xoxoaudiolabs/XO-Hugbox/hardware/mechanical/alu_acrylic/xo_hugbox_alu_shell.step

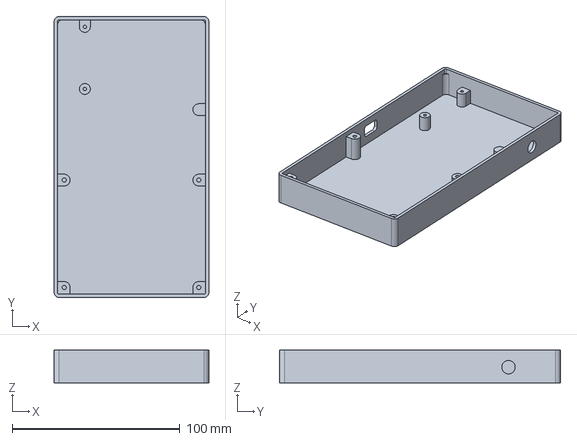
[picture p7: CAD file, 2026-11-07]
hardware/mechanical/alu_acrylic/xo_hugbox_alu_shell.step
92.2 x 167.5 x 19.6 mm
