xoxoaudiolabs/XO-Hugbox/hardware/mechanical/xo_hugbox_top_plate.stl

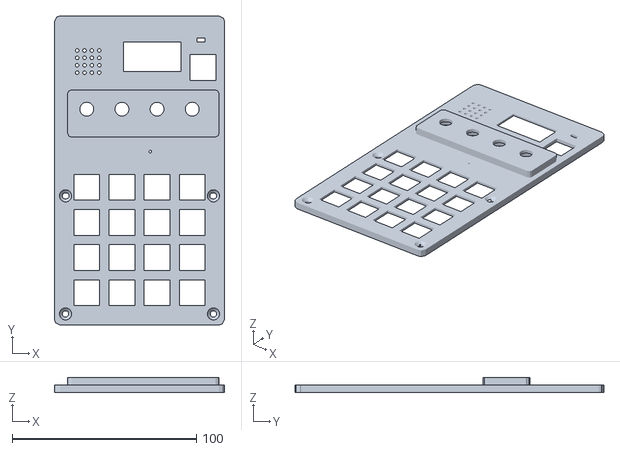
[picture p8: CAD file, 2026-11-06]
hardware/mechanical/xo_hugbox_top_plate.stl
92.2 x 167.5 x 8.12
