xoxoaudiolabs/XO-Hugbox/hardware/mechanical/alu_acrylic/xo_hugbox_acrylic.stl

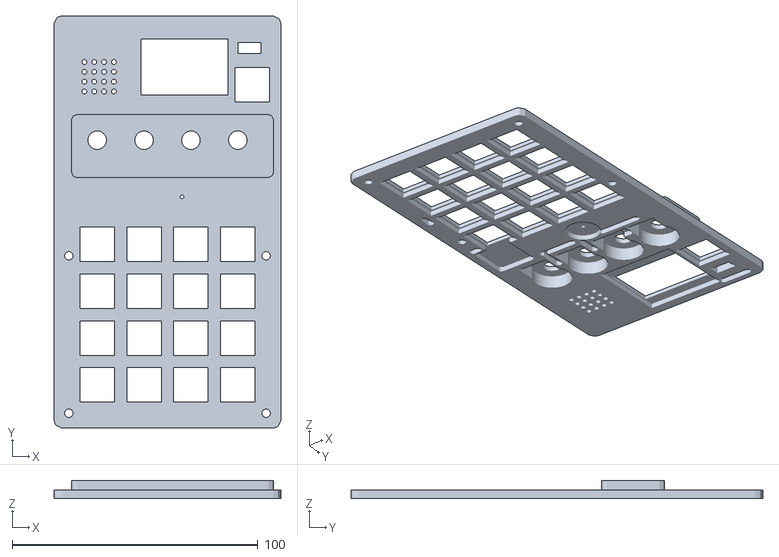
[picture p9: CAD file, 2026-11-07]
hardware/mechanical/alu_acrylic/xo_hugbox_acrylic.stl
92.2 x 167.5 x 7.50
