xoxoaudiolabs/XO-Hugbox/hardware/mechanical/xo_hugbox_shell.stl

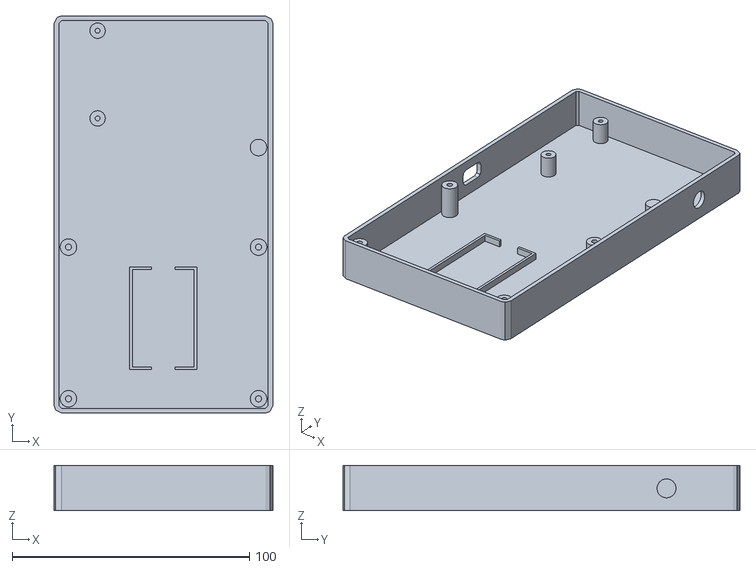
[picture p10: CAD file, 2026-11-05]
hardware/mechanical/xo_hugbox_shell.stl
92.2 x 167.5 x 19.1
