xoxoaudiolabs/XO-Hugbox/hardware/mechanical/alu_acrylic/xo_hugbox_acrylic_L4.dxf

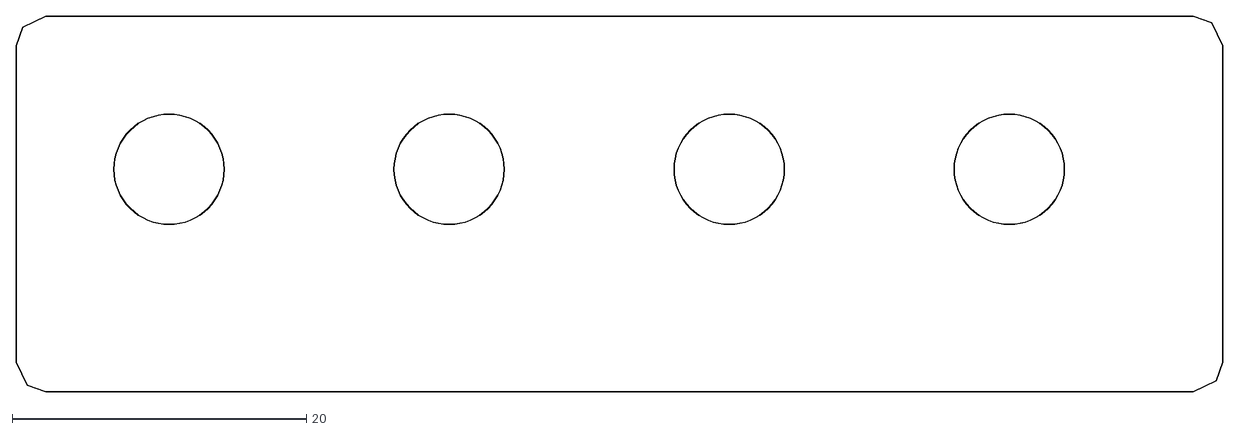
[picture p11: CAD file, 2026-11-07]
hardware/mechanical/alu_acrylic/xo_hugbox_acrylic_L4.dxf
82.1 x 25.5
