xoxoaudiolabs/XO-Hugbox/hardware/mechanical/alu_acrylic/xo_hugbox_acrylic_L2.dxf

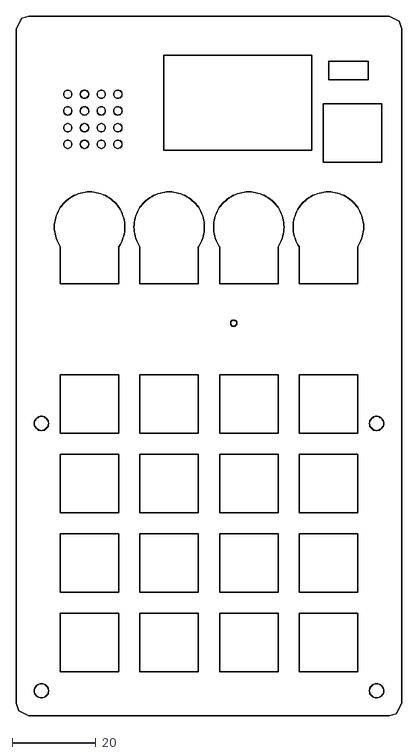
[picture p12: CAD file, 2026-11-07]
hardware/mechanical/alu_acrylic/xo_hugbox_acrylic_L2.dxf
92.2 x 167.5
