xoxoaudiolabs/XO-Hugbox/hardware/mechanical/alu_acrylic/xo_hugbox_acrylic_L3.dxf

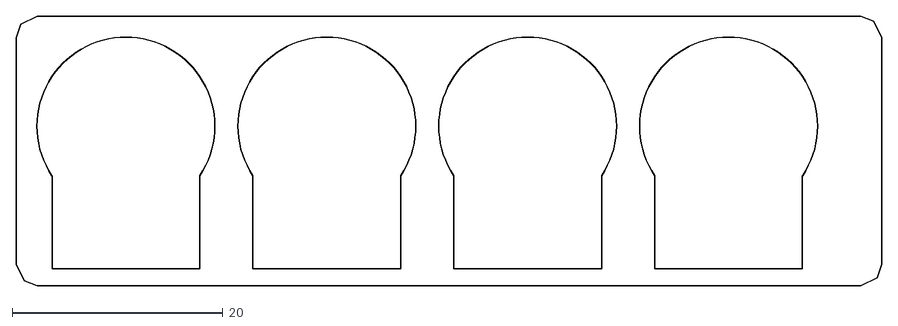
[picture p13: CAD file, 2026-11-07]
hardware/mechanical/alu_acrylic/xo_hugbox_acrylic_L3.dxf
82.1 x 25.5
