xoxoaudiolabs/XO-Hugbox/hardware/mechanical/alu_acrylic/xo_hugbox_acrylic_L1.dxf

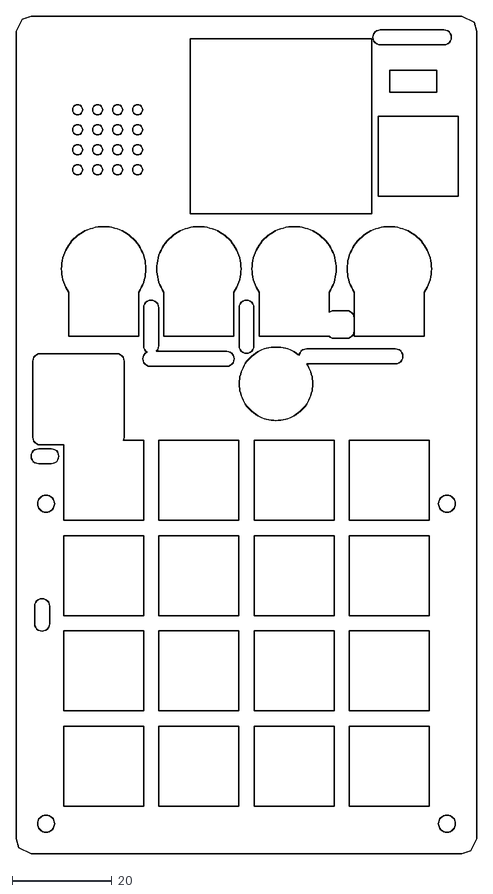
[picture p14: CAD file, 2026-11-07]
hardware/mechanical/alu_acrylic/xo_hugbox_acrylic_L1.dxf
92.2 x 167.5
