xoxoaudiolabs/XO-Hugbox/hardware/mechanical/alu_acrylic/xo_hugbox_acrylic.scad

// XO-Hugbox - clear acrylic faceplate, 4 laser-cut layers (generated by gen_acrylic.py from layout.py; do not edit)
// layer=1..4 -> that layer's 2D outline (export DXF/SVG); layer=0 -> 3D stack in shell coordinates (preview).
// 1: under-layer 2.0 mm   2: switch plate 1.5 mm   3: knob spacer 2.0 mm   4: knob top 2.0 mm
layer=0;
W=92.2; H=167.5; r=3; pitch=19.05;
z1=19.60; z2=21.60; z3=23.10; z4=25.10;   // layer undersides (shell z); can top 25.22
t1=2.0; t2=1.5; t3=2.0; t4=2.0;
pot_y=117.0; can_d=16.87; shaft_d=7.5; lug_reach=12.52; strip_front=15.12; strip_x0=7.125;
oled_c=[53.00,145.70]; oled_pcb=[36.4,35.00]; oled_pcb_cy=145.50;
oled_glass=[35.50,22.73]; oled_glass_off=1.08;
spk_c=[18.30,142.80]; grille_r=10;
shift=[80.5,139.5]; pwr=[79.5,154.5]; pwr_window=true;
mic_c=[52.0,94.0]; mic_d=13.9; mic_hole=1.5;
top_holes=[[6, 6], [86.2, 6], [6, 70], [86.2, 70]];   // corners only: the knob strip has no screw (support post under it)
reliefs=[[[11.5, 80.5]], [[72.9, 163.3], [75.44, 163.3], [77.98, 163.3], [80.52, 163.3], [83.06, 163.3], [85.6, 163.3]], [[4.88, 98.52], [7.42, 98.52], [9.96, 98.52], [12.5, 98.52], [15.04, 98.52], [17.58, 98.52], [20.12, 98.52], [4.88, 83.28], [7.42, 83.28], [9.96, 83.28], [12.5, 83.28], [15.04, 83.28], [17.58, 83.28], [20.12, 83.28]], [[4.5, 79.5], [7.04, 79.5]], [[63.6, 104.6], [66.14, 104.6], [63.6, 107.14], [66.14, 107.14]], [[5.2, 46.0], [5.2, 49.5]], [[58.11, 99.5], [60.65, 99.5], [63.19, 99.5], [65.73, 99.5], [68.27, 99.5], [70.81, 99.5], [73.35, 99.5], [75.89, 99.5]], [[26.88, 99.0], [29.42, 99.0], [31.96, 99.0], [34.5, 99.0], [37.04, 99.0], [39.58, 99.0], [42.12, 99.0]], [[46.1, 101.6], [46.1, 109.22]], [[27.0, 101.6], [27.0, 109.22]]];
function cx(i)=8.0+pitch/2+i*pitch; function cy(j)=8.0+pitch/2+j*pitch;
keys=[for(i=[0:3]) for(j=[0:3]) [cx(i),cy(j)], shift];
module sq(c,s) translate([c[0]-s[0]/2,c[1]-s[1]/2]) square(s);
module outline() offset(r=r) offset(delta=-r) square([W,H]);
module strip() translate([strip_x0,pot_y-strip_front]) offset(r=2) offset(delta=-2) square([W-3-strip_x0,strip_front+10.4]);
module screws(pts) for(p=pts) translate(p) circle(d=3.4,$fn=32);
module cans() for(i=[0:3]) translate([cx(i),pot_y]) circle(d=can_d,$fn=96);
module lugs() for(i=[0:3]) translate([cx(i)-7,pot_y-(lug_reach+1.0)]) square([14,lug_reach+1.0]);
module grille() for(dx=[-grille_r:4:grille_r]) for(dy=[-grille_r:4:grille_r]) if(dx*dx+dy*dy<=grille_r*grille_r)
  translate([spk_c[0]+dx,spk_c[1]+dy]) circle(d=2,$fn=24);
module pwr_cut() if(pwr_window) sq(pwr,[9.4,4.4]); else sq(pwr,[4.3,2.1]);

// 1: under-layer - switch pockets, every part on the board top, header rows, speaker grille (speaker face seals here)
module l1() difference(){ outline();
  for(k=keys) sq(k,[16,16]);
  cans(); lugs();
  sq([oled_c[0],oled_pcb_cy],oled_pcb);
  translate(mic_c) circle(d=mic_d+0.8,$fn=96);
  sq(pwr,[9.4,4.4]);
  for(p=reliefs) hull() for(q=p) translate(q) circle(r=1.5,$fn=24);
  grille(); screws(top_holes);
}
// 2: switch plate - 14 mm MX holes, OLED glass window, mic sound hole, grille
module l2() difference(){ outline();
  for(k=keys) sq(k,[14,14]);
  cans(); lugs();
  sq([oled_c[0],oled_c[1]+oled_glass_off],oled_glass);
  translate(mic_c) circle(d=mic_hole,$fn=32);
  pwr_cut(); grille(); screws(top_holes);
}
// 3: knob spacer - cans + solder lugs
module l3() difference(){ strip(); cans(); lugs(); }
// 4: knob top - shaft holes; the pot nuts clamp it to the cans
module l4() difference(){ strip(); for(i=[0:3]) translate([cx(i),pot_y]) circle(d=shaft_d,$fn=64); }

if(layer==1) l1(); else if(layer==2) l2(); else if(layer==3) l3(); else if(layer==4) l4();
else color("#cfe8ff",0.55){
  translate([0,0,z1]) linear_extrude(t1) l1();
  translate([0,0,z2]) linear_extrude(t2) l2();
  translate([0,0,z3]) linear_extrude(t3) l3();
  translate([0,0,z4]) linear_extrude(t4) l4();
}
