xoxoaudiolabs/XO-Hugbox/(list of files, cad)

Other CAD files:
hardware/mechanical/alu_acrylic/xo_hugbox_alu_shell.stl
