xoxoaudiolabs/XO-Hugbox/docs/build-guide/index.html

Explode Case X-ray shell + plate 3/4TopBottom

Loading the model…

XOXO Audio Labs · Build guide

# XO-Hugbox

Prototype

Geometry from layout.py, the routed KiCad board and the shell / plate STLs.

← BackNext →
