xoxoaudiolabs/XO-Hugbox/(list of files, drawings)

Other design files:
hardware/pcb/xo_hugbox.dsn
hardware/pcb/xo_hugbox_v11.dsn
