xoxoaudiolabs/XO-Hugbox/hardware/pcb/xo_hugbox.kicad_pcb

## KiCad design hardware/pcb/xo_hugbox.kicad_pcb (2026-11-06)

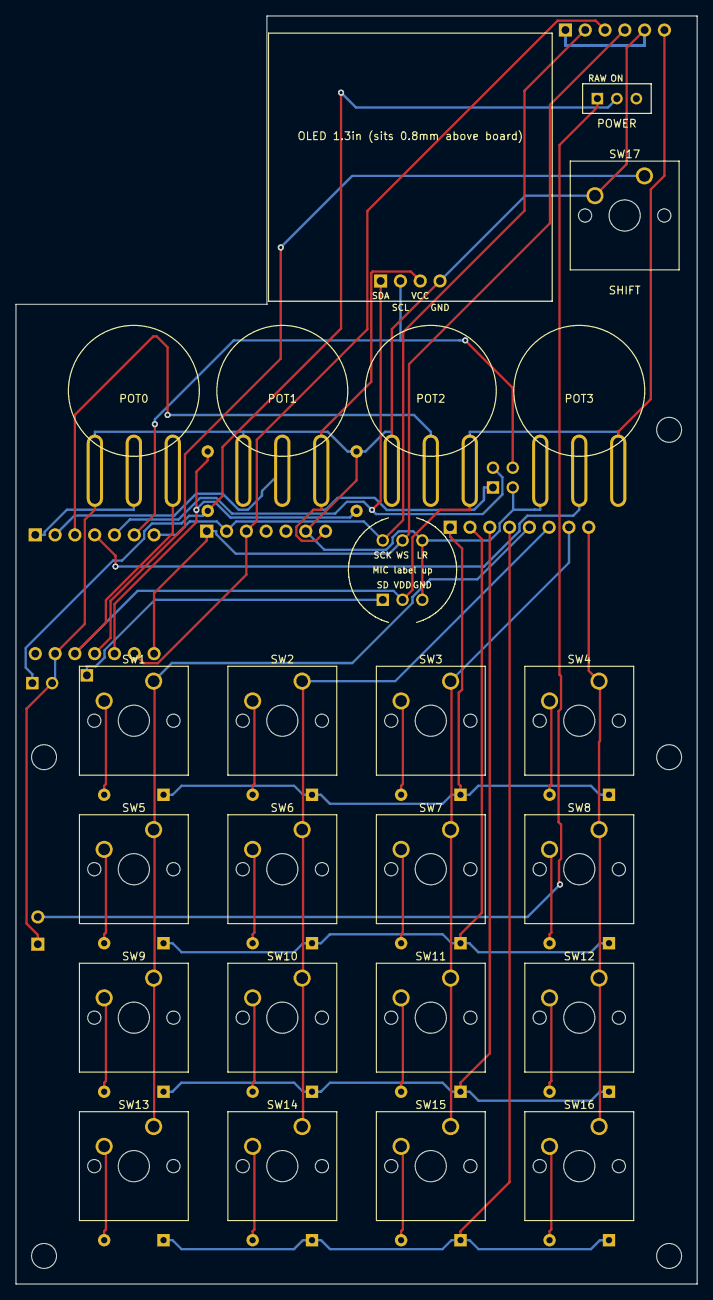
[picture p15: board xo_hugbox.kicad_pcb from above]

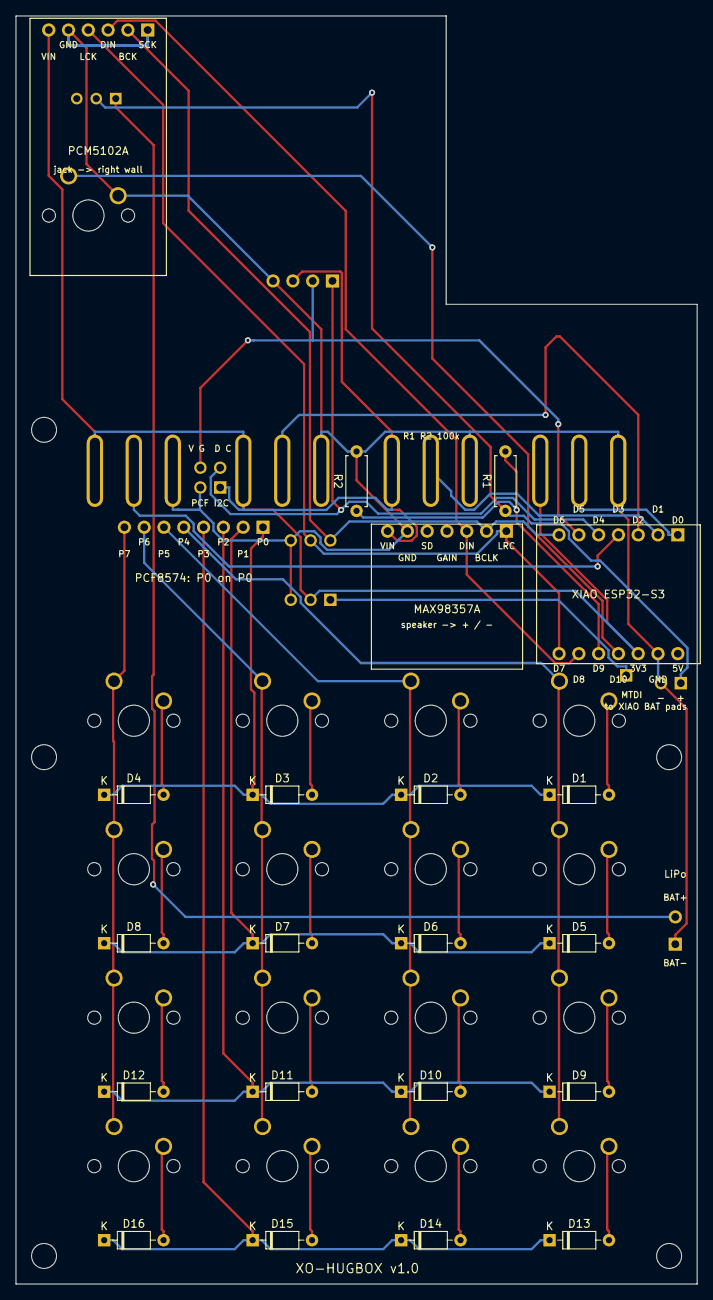
[picture p16: board xo_hugbox.kicad_pcb from below]

Board: 2 copper layers, 87.4 x 162.7 mm, 55 parts (18 on the bottom side), 40 nets.

Parts:
D1, D2, D3, D4, D5, D6, D7, D8, D9, D10, D11, D12, D13, D14, D15, D16: D_DO-35_SOD27_P7.62mm_Horizontal
H1, H2, H3, H4, H5: MountingHole_3.2mm_M3
J9: J9
J11: J11
J13: J13
J_MIC: J_MIC
J_MTDI: J_MTDI
R1, R2: R_Axial_DIN0207_L6.3mm_D2.5mm_P7.62mm_Horizontal
RV1: RV1
RV2: RV2
RV3: RV3
RV4: RV4
SW1, SW2, SW3, SW4, SW5, SW6, SW7, SW8, SW9, SW10, SW11, SW12, SW13, SW14, SW15, SW16, SW17: SW_Cherry_MX_1.00u_PCB
SW18: SW18
U1: U1
U2: U2
U3: U3
U4: U4
U5: U5

Connections:
3V3: J9.1, J_MIC.2, RV1.3, RV2.3, RV3.3, RV4.3, U1.10, U3.7, U4.6, U5.3
BAT_RAW: J11.2, SW18.1
BAT_SW: J13.1, R1.1, SW18.2
BCK: J_MIC.4, U1.7, U3.2, U4.2
C0: SW1.1, SW5.1, SW9.1, SW13.1, U2.5
C1: SW2.1, SW6.1, SW10.1, SW14.1, U2.6
C2: SW3.1, SW7.1, SW11.1, SW15.1, U2.7
C3: SW4.1, SW8.1, SW12.1, SW16.1, U2.8
DIN: U1.13, U3.3, U4.3
GND: J9.2, J11.1, J13.2, J_MIC.3, J_MIC.6, R2.2, RV1.1, RV2.1, RV3.1, RV4.1, SW17.2, U1.9, U3.6, U4.1, U4.5, U5.4
LRCK: J_MIC.5, U1.14, U3.1, U4.4
MIC_SD: J_MIC.1, J_MTDI.1
POT0: RV1.2, U1.1
POT1: RV2.2, U1.2
POT2: RV3.2, U1.3
POT3: RV4.2, U1.4
R0: D1.1, D2.1, D3.1, D4.1, U2.1
R1: D5.1, D6.1, D7.1, D8.1, U2.2
R2: D9.1, D10.1, D11.1, D12.1, U2.3
R3: D13.1, D14.1, D15.1, D16.1, U2.4
SCL: J9.4, U1.6, U5.2
SDA: J9.3, U1.5, U5.1
SHIFT: SW17.1, U1.11
SWD1: D1.2, SW1.2
SWD2: D2.2, SW2.2
SWD3: D3.2, SW3.2
SWD4: D4.2, SW4.2
SWD5: D5.2, SW5.2
SWD6: D6.2, SW6.2
SWD7: D7.2, SW7.2
SWD8: D8.2, SW8.2
SWD9: D9.2, SW9.2
SWD10: D10.2, SW10.2
SWD11: D11.2, SW11.2
SWD12: D12.2, SW12.2
SWD13: D13.2, SW13.2
SWD14: D14.2, SW14.2
SWD15: D15.2, SW15.2
SWD16: D16.2, SW16.2
VSENSE: R1.2, R2.1, U1.12
