xoxoaudiolabs/XO-Hugbox/(commit log)

2026-11-05 XO-Hugbox: initial public release
    Pocket groovebox and MIDI controller from XOXO Audio Labs.
    - hardware: layout-driven KiCad 7 board (v1 + v1.1 speaker-line variant),
    gerbers, 3D-printed plate and shell, generation scripts
    - firmware: Arduino-ESP32 core 3.x on the XIAO ESP32-S3; shared C++ core
    with UI, sequencer, chords/arp, 6-voice synth, 16-pad sampler, FX,
    projects with autosave, USB + BLE MIDI; bring-up and v1.1 test builds
    - sim: browser emulator running the same core as WebAssembly
    - docs: interactive 3D build guide, hardware and firmware docs
    Licensed CERN-OHL-S-2.0 (hardware), MIT (software), CC BY-SA 4.0 (docs).
    [assembly.scad, xo_hugbox.dsn, xo_hugbox.kicad_pcb, xo_hugbox_shell.scad, xo_hugbox_shell.stl, xo_hugbox_top_plate.scad, xo_hugbox_top_plate.stl, xo_hugbox_v11.dsn]
2026-11-05 Fit the real pots, knobs and OLED (plate-only changes)
    Measured parts in hand; the PCB and gerbers are unchanged.
    - Pots: WH148 B10K are the straight-lug type (lugs 5.28 mm up, 4.38 mm
    past a 16.27 mm can). Diode-lead wire legs join the lugs to the oval
    slots; the plate gets a lug relief and a longer pot strip.
    - Knobs: 15x17 mm black aluminium, knurled, silver chamfer + pointer.
    - OLED: published 1.3" SH1106 sizes where the calipers agreed, measured
    glass (21.73 mm) where they did not. Glass pocket, window and board
    pocket moved/resized in the plate.
    - Build guide, emulator, assembly scene and docs regenerated to match.
    [assembly.scad, xo_hugbox_top_plate.scad, xo_hugbox_top_plate.stl]
2026-11-06 Add INMP441 mic pads to both boards, plate pocket and build steps
    Board v1 and v1.1 (pads and traces only, no new board parts):
    - J_MIC: SD, SCK, WS, LR, 3V3, GND under the mic pocket; SCK/WS on the
    shared BCK/LRCK nets, LR tied to GND.
    - J_MTDI: landing pad by the XIAO for a wire from its MTDI pad (GPIO41),
    routed to J_MIC SD on a new MIC_SD net.
    - Re-routed with Freerouting; 0 unconnected, no clearance errors. v1.1
    needed a single-threaded re-run (the first SES dropped one SCL wire);
    finalize.py now keeps via-to-via tracks KiCad 7 reports as dangling.
    Plate: mic pocket (port up) and 1.5 mm sound hole between the keys and
    the pot strip. Module size is a typical listing value until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
    [xo_hugbox.dsn, xo_hugbox.kicad_pcb, xo_hugbox_top_plate.scad, xo_hugbox_top_plate.stl, xo_hugbox_v11.dsn, xo_hugbox_v11.kicad_pcb]
2026-11-06 Redo the INMP441 mic mount for the real module's 2x3 pins
    The round breakout has two rows of three pins (SCK WS L/R / SD VDD GND,
    2.54 mm pitch, rows 7.62 mm apart) and is bottom-port: the sound port is
    the hole in the middle of the label side. So it now mounts label side up,
    straight on the main board on its own header, instead of six wires.
    - Boards v1 and v1.1: J_MIC is a 2x3 footprint centred under the sound
    hole, with labels and a silk outline; re-routed, 0 unconnected, DRC
    warning counts unchanged.
    - Plate: pocket 3.0 mm deep (label face sits 2.5 mm in, +0.5 for pin
    joints and a foam ring), 1.0 mm roof, 1.5 mm sound hole.
    - Build guide, parts list and mic plan updated. The row s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
    [xo_hugbox.dsn, xo_hugbox.kicad_pcb, xo_hugbox_top_plate.scad, xo_hugbox_top_plate.stl, xo_hugbox_v11.dsn, xo_hugbox_v11.kicad_pcb]
2026-11-06 Mic sampling and XOXO Studio's sample editor, in firmware and emulator
    SAMPLE view (Shift + REC held 0.6 s; a tap is still sequencer record):
    hold a pad to record the INMP441 onto it (up to 20 s, 300 ms pre-roll,
    optional start threshold), tap to select and play. Recorded pads show as
    U01-U16 everywhere and are saved to flash when you leave the view.
    The sample editor is a port of XOXO Studio's (sampler.py/sampleui.py):
    the same opening selection, fades, -6 dBFS normalise and reverse, and the
    same 128-column waveform with two markers. Knobs: START END FDIN FDOU,
    Shift: GAIN NORM REV SRC (USER/KIT). Threshold and monitor are on the
    SETTINGS shift knobs.
    - core: mic.cpp (recorder on the audi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
    [partitions_hugbox.csv]
2026-11-06 Record from anywhere: hold Shift + REC 2 s, beep, then record until release
    Press Shift, hold REC, let go of Shift: at 2 s a 150 ms 1 kHz beep plays and the
    take starts 100 ms after it on the selected pad, stopping when REC is let go.
    A release before 2 s is still sequencer record; letting go during the beep
    records nothing. Holding a pad in SAMPLE uses the same beep. The pre-roll now
    starts at the arm so the beep never lands in a take. Emulator, test and docs
    updated.
2026-11-06 One-handed sampling: record, trim, then save to the pad you tap; DRUM track is now SAMPLER
    Shift + REC held 1 s opens SAMPLE on READY (knobs GAIN, THRS, MON, SOURCE).
    Any pad records after the beep: held = while held, tapped = hands free until
    the next tap. The take opens in the Studio editor, and every knob change plays
    the result from a preview voice. Shift + REC asks SAVE TO PAD?; the tapped pad
    gets it, and a pad that already has a recording needs a second tap. SOURCE
    loads a kit sound or a recording to trim, copy or revert a pad. An unsaved
    take is dropped when you leave. Holding a pad in the editor (0.6 s) records
    a new take; a tap only plays it.
    The DRUM track is renamed SAMPLER (SMP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
2026-11-06 Emulator phone mode: just the Hugbox, full screen
    On phones (up to 640 px, or touch screens up to 940 px) the emulator shows only
    the Hugbox, filling the screen, with a Play button to start. A small "Emulator
    panels" button shows the rest underneath. Pad and Shift presses give a short
    buzz where the browser allows it, the computer-key letters on the keycaps are
    hidden, and opening SAMPLE asks for the phone's mic. Desktop is unchanged.
2026-11-06 Emulator as an installable web app
    Adds a web app manifest (fullscreen, portrait, black theme), Hugbox faceplate
    icons drawn from the layout by sim/tools/make_icons.py (192, 512, maskable
    512, Apple 180), the iPhone home-screen meta tags, and sw.js. The service
    worker keeps the app working offline and fetches the page network-first, so
    a new version shows up on the next launch with a connection. The panels
    get an "Install app" button where the browser offers installing, and a
    Share > Add to Home Screen note on iPhone. All paths are relative, so the
    same files work under any folder (e.g. /hugbox/).
2026-11-06 Emulator knobs: smooth trackpad scrolling, sideways drag
    Scrolling over a knob now turns it by how far the swipe moves instead of a
    fixed step per event, so a Mac trackpad's stream of small events no longer
    spins it end to end; a mouse wheel notch is still 1/32 of the travel. Up is
    higher as the fingers move, allowing for macOS natural scrolling (Safari
    reports it; elsewhere on a Mac it is assumed). Dragging right turns it up as
    well as dragging up, and pinching over a knob is ignored.
2026-11-06 Cleaner synth output, knob pick-up for negative values, feature tests
    - Synth gain down ~4 dB: 6 voices at high resonance now stay below the
    limiter instead of being squashed into a gritty, clipped-sounding chord.
    - Output limiter (dsp::limit) is linear up to -6 dBFS and rounds off only
    the peaks above it; the old tanh curve bent every level a little
    (1.6 % distortion on a 6-note chord, 3.9 % with RES 100). Final output
    is clamped so the mic monitor and beep can never wrap the int16.
    - Knob pick-up: a knob now starts its sweep where it points when the page
    appears, so it picks up a value it already sits on, and the "no previous
    position" marker is no longer -1, so negative values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
2026-11-06 Mark the board being ordered as v1.0
    Silkscreen reads XO-HUGBOX v1.0; only the label changed (DRC unchanged:
    0 unconnected). Gerbers and build guide regenerated.
    [xo_hugbox.kicad_pcb]
2026-11-06 Build guide: mic goes in before the PCF8574T
    J_MIC's pins come through the board under the PCF8574T module, so they
    can't be soldered once it is on. The mic is now its own step 4 (top,
    soldered and clipped flush), before the PCF; later steps renumbered.
2026-11-07 Hardware: the v1.0 PCB cost from the PCBWay order
2026-11-07 Hardware: the PCB cost broken down; duty is paid up front
2026-11-07 Hardware: aluminium shell + clear acrylic faceplate variant
    A CNC black anodized 6061 shell (STEP via CadQuery) and a 4-layer laser-cut
    acrylic faceplate (DXF per layer), both generated from layout.py. Same v1.0
    PCB; the printed shell and plate are unchanged.
    [xo_hugbox_acrylic.scad, xo_hugbox_acrylic_L1.dxf, xo_hugbox_acrylic_L2.dxf, xo_hugbox_acrylic_L3.dxf, xo_hugbox_acrylic_L4.dxf, xo_hugbox_alu_shell.step, xo_hugbox_alu_shell.stl]
2026-11-07 Build guide + emulator: case view for the aluminium + acrylic variant
    The guide gets a Case menu (3D-printed / aluminium + acrylic) that swaps the
    shell and plate models, spacers, screws, mic height, antenna and the step
    text and parts list. The emulator's Board card gets the same choice for its
    top-view drawing.
    [xo_hugbox_acrylic.stl]
2026-11-07 Aluminium + acrylic: no screw by the knobs
    Like the printed plate, the knob strip has no screw: the fifth boss is a
    plain support post (no tapped hole) and the acrylic layers have no hole
    there. Corner screws only: 4x M3x12 button head. Guide, emulator and README
    updated to match.
    [xo_hugbox_acrylic.scad, xo_hugbox_acrylic.stl, xo_hugbox_acrylic_L1.dxf, xo_hugbox_acrylic_L2.dxf, xo_hugbox_acrylic_L3.dxf, xo_hugbox_acrylic_L4.dxf, xo_hugbox_alu_shell.step, xo_hugbox_alu_shell.stl]
2026-11-07 Emulator: bigger audio buffer on phones
    On a touch device the page now renders audio in 4096-frame blocks
    instead of 1024. The audio runs on the main thread between screen
    redraws, and a phone (more so over Bluetooth) missed 23 ms deadlines
    now and then, heard as crackle with the arp on. The synth output
    itself was clean in every scale, octave and arp setting.
2026-11-07 Docs: parts cost is about $60-85 per unit, not under $50
    Rough per-part estimate in docs/hardware.md; only the PCB figure is a real order.
